LSaber36/smart-outlet/README.md

# smart-outlet
This repository is for a smart outlet project.
The smart-outlet will be able to read current and turn the outlet on and off.
Combining these basic inputs and outputs with features in the app, a user will have 
full control over the power they are using from the given outlet.
