LSaber36/smart-outlet/firmware/README.md

# firmware
This directory will hold all of the code that allows the physical device to work.

NOTE:
The firebase communication will not work without the firebaseInfo.h file being in the smartOutlet project folder.
This is being left out for security purposes.
