LSaber36/smart-outlet/eagle-files/SmartOutlet/Motherboard.brd

## EAGLE design eagle-files/SmartOutlet/Motherboard.brd (2022-07-14)

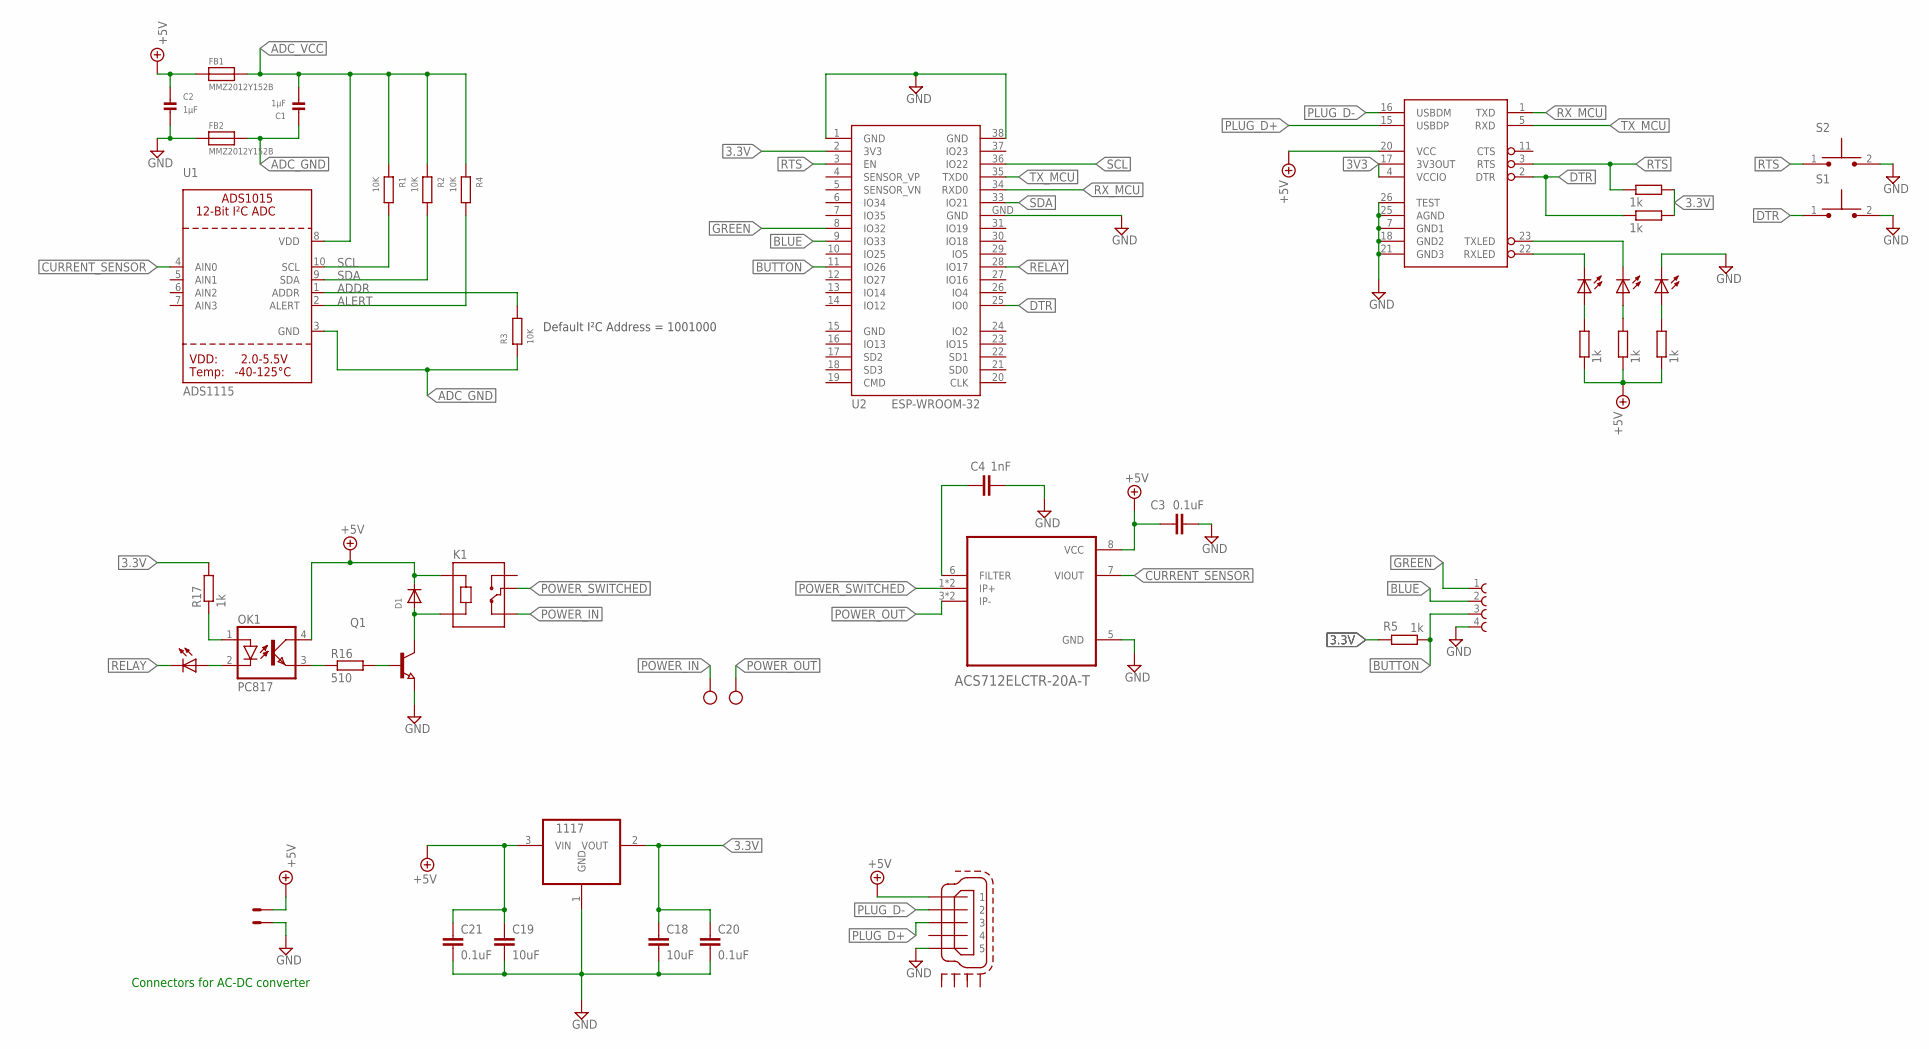
[picture p1: schematic Motherboard.sch]

Parts:
C1, C2: 1µF; 0805
C3, C20, C21: 0.1uF; 0603
C4: 1nF; 0603
C18, C19: 10uF; 1206
D1: DIODE_SOD-123FL; SOD-123FL
FB1, FB2: MMZ2012Y152B; 0805
IC1: 1117; SOT223
K1: SRD-05VDC-SL-C; RELAY_SRD-05VDC-SL-C
K2: 68610414122
OK1: PC817; DIL04
POWER_LED: LEDCHIP-LED0603; CHIP-LED0603
Q1: NPN-TRANSISTOR_SOT23; SOT23
R1, R2, R3, R4: 10K; R0603
R5, R7, R8, R9, R10, R11, R17: 1k; R0603
R16: 510; R0603
RELAY: LEDCHIP-LED0603; CHIP-LED0603
RX_LED: LEDCHIP-LED0603; CHIP-LED0603
S1, S2: TL1015AF160QG; SW_TL1015AF160QG
TX_LED: LEDCHIP-LED0603; CHIP-LED0603
U1: ADS1115; MSOP10
U2: ESP-WROOM-32
U3: FT232RL; SSOP28DB
U4: ACS712ELCTR-20A-T; SOIC127P600X175-8N
U$2: ZX62D-B-5P8
X1: W237-102
X2: 22-23-2021

Connections:
3.3V: C18.1, C20.1, IC1.2 (VOUT), R5.1, R8.2, R11.2, R17.2, U2.2 (3V3)
3V3: U3.4 (VCCIO), U3.17 (3V3OUT)
+5V: C2.1, C3.1, C19.1, C21.1, D1.C, FB1.1, IC1.3 (VIN), K1.A1, OK1.4 (COL), R7.1, R9.1, R10.1, U3.20 (VCC), U4.8 (VCC), U$2.P$1 (1), X2.1
ACS_FILTER: C4.1, U4.6 (FILTER)
ADC_GND: C1.1, FB2.2, R3.1, U1.3 (GND)
ADC_VCC: C1.2, FB1.2, R1.1, R2.1, R4.1, U1.8 (VDD)
ADDR: R3.2, U1.1 (ADDR)
ALERT: R4.2, U1.2 (ALERT)
BLUE: K2.2, U2.9 (IO33)
BUTTON: K2.3, R5.2, U2.11 (IO26)
CURRENT_SENSOR: U1.4 (AIN0), U4.7 (VIOUT)
DTR: R11.1, S1.1, U2.25 (IO0), U3.2 (DTR)
GND: C2.2, C3.2, C4.2, C18.2, C19.2, C20.2, C21.2, FB2.1, IC1.1 (GND), K2.4, POWER_LED.C, Q1.2 (E), S1.2, S2.2, U2.1 (GND), U2.15 (GND), U2.38 (GND), U2.GND, U3.7 (GND1), U3.18 (GND2), U3.21 (GND3), U3.25 (AGND), U3.26 (TEST), U4.5 (GND), U$2.P$5 (5), X2.2
GREEN: K2.1, U2.8 (IO32)
unnamed: OK1.2 (C), RELAY.A
unnamed: OK1.1 (A), R17.1
unnamed: R10.2, TX_LED.A
unnamed: OK1.3 (EMIT), R16.1
unnamed: Q1.1 (B), R16.2
unnamed: R9.2, RX_LED.A
PLUG_D+: U3.15 (USBDP), U$2.P$3 (3)
PLUG_D-: U3.16 (USBDM), U$2.P$2 (2)
POWER_IN: K1.NC, X1.1
POWER_LED: POWER_LED.A, R7.2
POWER_OUT: U4.3 (IP-), U4.4 (IP-), X1.2
POWER_SWITCHED: K1.COM, U4.1 (IP+), U4.2 (IP+)
RELAY: RELAY.C, U2.28 (IO17)
RELAY_GND: D1.A, K1.A2, Q1.3 (C)
RTS: R8.1, S2.1, U2.3 (EN), U3.3 (RTS)
RX_LED: RX_LED.C, U3.22 (RXLED)
RX_MCU: U2.34 (RXD0), U3.1 (TXD)
SCL: R1.2, U1.10 (SCL), U2.36 (IO22)
SDA: R2.2, U1.9 (SDA), U2.33 (IO21)
TX_LED: TX_LED.C, U3.23 (TXLED)
TX_MCU: U2.35 (TXD0), U3.5 (RXD)

Notes on the sheet:
Default I²C Address = 1001000
Connectors for AC-DC converter

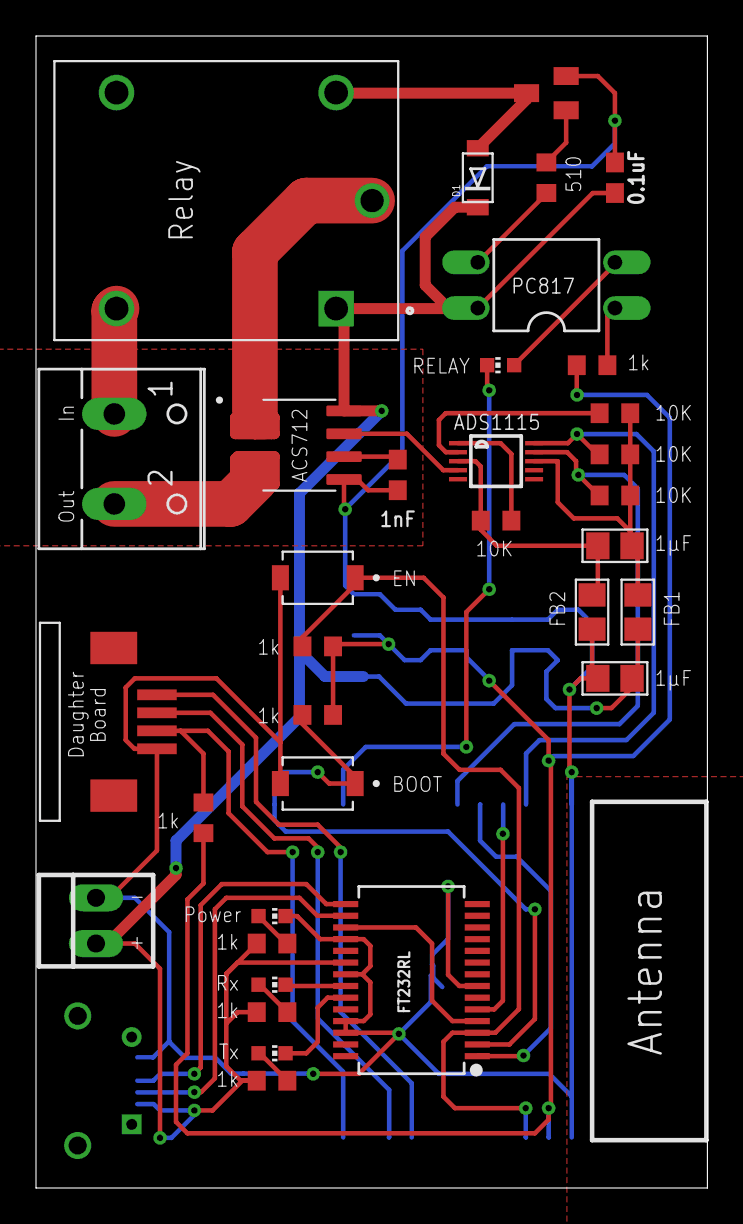
[picture p2: board Motherboard.brd from above]

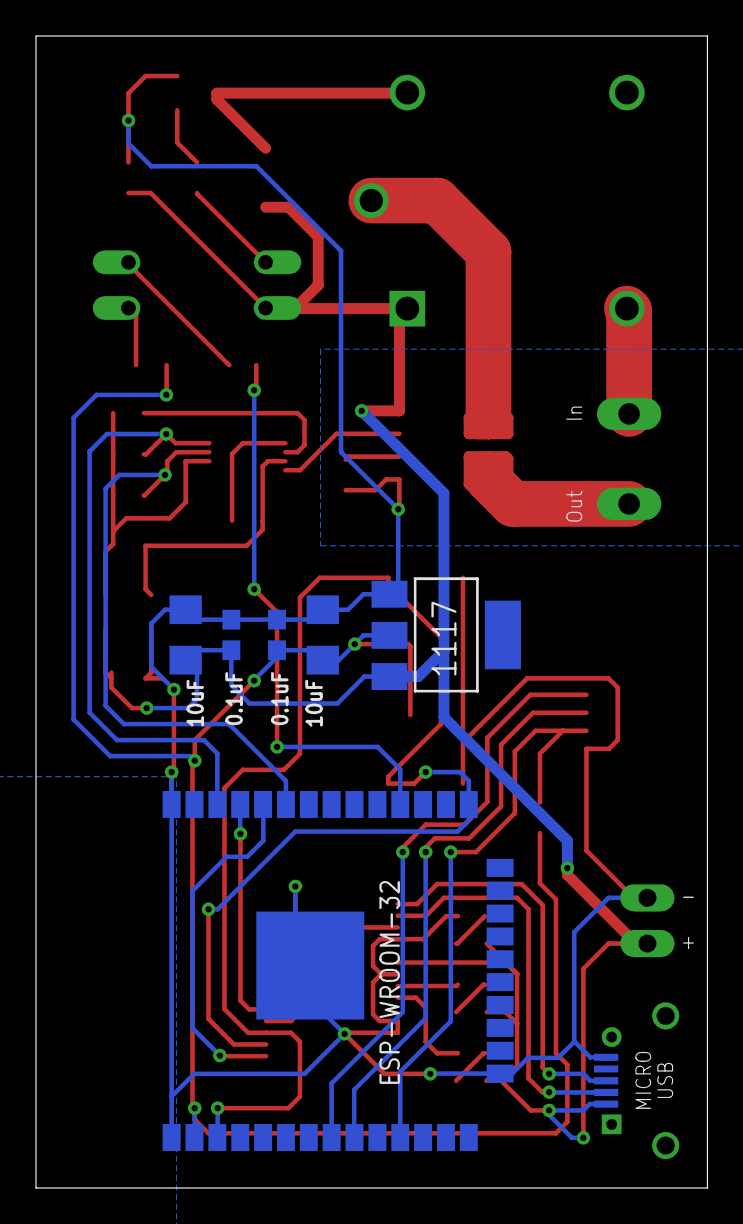
[picture p3: board Motherboard.brd from below]

Board: 2 copper layers, 37.3 x 64.0 mm, 41 parts (7 on the bottom side), 35 nets.
