LSaber36/smart-outlet/eagle-files/SmartOutlet/ButtonLedBoard.brd

## EAGLE design eagle-files/SmartOutlet/ButtonLedBoard.brd (2022-07-08)

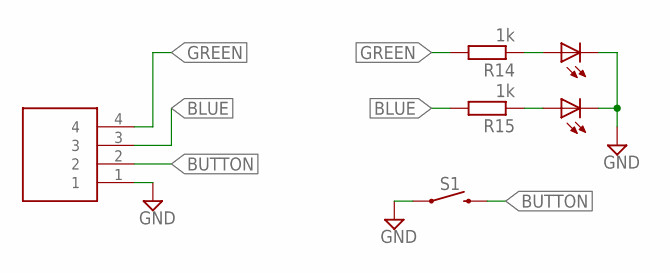
[picture p4: schematic ButtonLedBoard.sch]

Parts:
J1: 826629-4; TE_826629-4
LED1, LED2: LEDCHIP-LED0603; CHIP-LED0603
R14, R15: 1k; R0603
S1: MOMENTARY-SWITCH-SPST-SMD-6.0X3.5MM; TACTILE_SWITCH_SMD_6.0X3.5MM

Connections:
BLUE: J1.3, R15.2
BUTTON: J1.2, S1.2
GND: J1.1, LED1.C, LED2.C, S1.1
GREEN: J1.4, R14.2
unnamed: LED1.A, R14.1
unnamed: LED2.A, R15.1

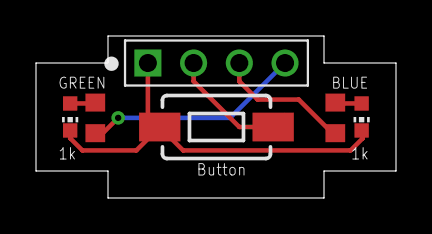
[picture p5: board ButtonLedBoard.brd from above]

Board: 2 copper layers, 20.0 x 9.0 mm, 6 parts (0 on the bottom side), 6 nets.
