LSaber36/smart-outlet/firmware/smartOutlet/smartOutlet.ino

#include <Adafruit_ADS1X15.h>
#include <WiFi.h>
#include <Firebase_ESP_Client.h>
#include <addons/TokenHelper.h>
#include <addons/RTDBHelper.h>
#include "firebaseInfo.h"
#include "time.h"

#include <BLEDevice.h>
#include <BLEServer.h>
#include <BLEUtils.h>
#include <BLE2902.h>

#include <Preferences.h>

#define GREEN_LED 32
#define BLUE_LED 33
#define BUTTON_PIN 26
#define RELAY_PIN 17
#define NUM_SAMPLES 50
#define UPDATE_INTERVAL 3000
#define ADC_READ_INTERVAL 5  // In minutes

#define SHORT_PRESS_TIME 1000
#define LONG_PRESS_TIME 3000
#define MULTI_BUTTON_PRESS_TIME 750
#define NUM_MULTI_PRESS 3
#define WIFI_TIMEOUT 6000

#define SERVICE_UUID            "6E400001-B5A3-F393-E0A9-E50E24DCCA9E"
#define CHARACTERISTIC_UUID_RX  "6E400002-B5A3-F393-E0A9-E50E24DCCA9E"
#define CHARACTERISTIC_UUID_TX  "6E400003-B5A3-F393-E0A9-E50E24DCCA9E"

enum RECEIVED_DATA_UPDATE
{
  NO_CHANGE = 0,
  RELAY_STATE = 1,
  POWER_THRESHOLD = 2,
  INITIAL_UPDATE = 3
};

// Define preferences object for flash access
Preferences savedInfo;
String currentSsid, currentPass, currentUuid;
volatile bool hasSavedInfo = false;

// Define ADC object
Adafruit_ADS1015 ads;

// Define Firebase Data objects
FirebaseData stream;
FirebaseData fbdo;

// Define Firebase auth and config objects
FirebaseAuth auth;
FirebaseConfig config;

unsigned long sendDataPrevMillis = 0;

// Realtime Data
volatile bool firstStreamUpdate = true, firebaseEstablished = false;
volatile int dataChanged = NO_CHANGE;
String deviceID = "";
String stateDatapath = "";

// ADC data
float ADCMultiplier = 2.0F;
float ADCResult;  //Voltage
float ADCValue;   //Current
float averageVoltage;
float maxv;
float power;
uint8_t sampleCounter;
unsigned long prevADCTime = 0;
bool firstADCCheck = true;

bool ADCInitialized = false;

// Button data
uint8_t currButtonState = 1;
uint8_t prevButtonState = 1;
unsigned long prevMillis = 0, releasedPressTime = 0, depressedPressTime = 0;
unsigned long prevButtonCountTime = 0, buttonCountTime = 0;
uint8_t buttonPressCount = 0;
volatile bool prevRelayState, relayState = false;
volatile int powerThreshold = 0;
volatile bool powerThresholdExceeded = false;

// Bluetooth data
BLEServer *pServer = NULL;
BLEService *pService;
BLECharacteristic *TxChar;
BLECharacteristic *RxChar;
bool deviceConnected = false;
bool oldDeviceConnected = false;
int8_t incomingData = 0, incomingDataCounter = 0;

// Define time variables
const char* ntpServer = "pool.ntp.org";
struct tm timeInfo;
int8_t prevMin = 0, timerMin = 0;
int8_t prevHour = 0;
float currentHourCumSum = 0;

// Mode for knowing wheter to boot in normal operation or in pairing mode
String mode;

void setup()
{
  Serial.begin(115200);
  Serial.printf("Starting Program...\n\n");
  
  // Init pinmodes
  pinMode(GREEN_LED, OUTPUT);
  pinMode(BLUE_LED, OUTPUT);
  pinMode(RELAY_PIN, OUTPUT);
  pinMode(BUTTON_PIN, INPUT_PULLUP);

  // Turn the relay off
  digitalWrite(RELAY_PIN, HIGH);

  // Check flash for existing values and print them
  getSavedInfo(&currentSsid, &currentPass, &currentUuid);
  Serial.printf("ssid: %s\n", currentSsid.c_str());
  Serial.printf("pass: %s\n", currentPass.c_str());
  Serial.printf("uuid: %s\n", currentUuid.c_str());
  Serial.println();

  getMode(&mode);
  Serial.printf("Mode: %s\n", mode);

  if (mode == "")
  {
    putMode("normal");
    mode = "normal";
  }
  // If there's ever the bug with the UUID being "7", don't let the outlet enter normal mode
  // The user MUST repair the outlet to get past this
  else if (currentUuid == "7")
  {
    mode = "pairing";
  }

  if (mode == "pairing")
  {
    Serial.println("Entered pairing mode");
    digitalWrite(GREEN_LED, LOW);
    digitalWrite(BLUE_LED, LOW);
    enterPairingMode();
  }
  else if (mode == "normal")
  {
    Serial.println("Entered normal mode");
    if (currentSsid == "" || currentPass == "" || currentUuid == "")
    {
      Serial.println("No data found, can't connect to network");
      hasSavedInfo = false;
    }
    else if (currentSsid != "" || currentPass != "" || currentUuid != "")
    {
      Serial.println("Found data, attempting network connection");
      hasSavedInfo = true;
      deviceID = currentUuid;
      stateDatapath = deviceID + "/state";
      setupWiFi(currentSsid, currentPass);
      delay(750);
      setupFirebase();
      setupADC();
    }
  }
}

void loop()
{
  getButtons();

  if (mode == "normal")
  {
    syncFirebase();
    getADCReading();

    if (dataChanged != NO_CHANGE)
    {
      if (firstStreamUpdate)
      {
        firstStreamUpdate = false;
        firebaseEstablished = true;
        Serial.println("\nFirebase Connection Established");

        getTime(&timeInfo);
        prevMin = timeInfo.tm_min;
        timerMin = timeInfo.tm_min;
        prevHour = timeInfo.tm_hour;
        Serial.printf("Current minutes: %d\n", timeInfo.tm_min);
        
        // Initialize the currentHourCumSum to what's in the database for the current hour in case of a power failure
        currentHourCumSum = getHistoricalData(timeInfo.tm_hour);
        Serial.printf("Set currentHourCumSum: %.1f\n", currentHourCumSum);

        // Indicate that the code is running
        blinkLED(GREEN_LED, 100, 150, 2);
        blinkLED(BLUE_LED, 100, 150, 2);
      }

      // Process new data received away from callback for efficiency
      if (dataChanged == RELAY_STATE)
      {
        Serial.printf("Received state update: %s\n", (relayState) ? "true" : "false");
      }
      else if (dataChanged == POWER_THRESHOLD)
      {
        Serial.printf("Received threshold update: %d\n", powerThreshold);
      }
      else if (dataChanged == INITIAL_UPDATE)
      {
        Serial.println("Initial update, initializing variables");
        Serial.printf("powerThreshold: %d\n", powerThreshold);
        Serial.printf("state: %s\n", (relayState) ? "true" : "false");
      }
      
      dataChanged = NO_CHANGE;
    }

    // Only call digitalWrite if the state has changed (reduces unnecessary calls)
    if (relayState != prevRelayState)
    {
      digitalWrite(RELAY_PIN, relayState);
      digitalWrite(GREEN_LED, relayState);
    }

    prevRelayState = relayState;
  }
  else if (mode == "pairing")
  {
    if (deviceConnected)
    {        
      delay(1000); // bluetooth stack will go into congestion, if too many packets are sent
    }

    if (!deviceConnected && oldDeviceConnected)
    {
      // Do stuff here after disconnected
      // give the bluetooth stack the chance to get things ready
      delay(500);
      
      oldDeviceConnected = deviceConnected;
    }
    if (deviceConnected && !oldDeviceConnected)
    {
      // Do stuff here after connection is established
      blinkLED(BLUE_LED, 100, 300, 2);
      oldDeviceConnected = deviceConnected;
    }
  }

  // This is necessary to avoid watchdog timer errors
  delay(10);
}
