LSaber36/smart-outlet/firmware/smartOutlet/currentSensorFunctions.ino

void setupADC()
{
  ads.setGain(GAIN_ONE);
  Serial.println("Attempting to initialize ADS");

  if (!ads.begin())
  {
    Serial.println("Failed to initialize ADS.");
  }
  else
  {
    Serial.println("Initialized ADS");
    ADCInitialized = true;
  
    sampleCounter = 0;
    averageVoltage = 0;

    while (sampleCounter < 50)
    {
      ADCResult = ads.readADC_SingleEnded(0) * ADCMultiplier / 1000;
      averageVoltage = averageVoltage + ADCResult;
      sampleCounter++;
      delay(4);
    }
    averageVoltage = averageVoltage / sampleCounter;
    maxv = averageVoltage;

  }
}

void getADCReading()
{
  // Without this if check, calling readADC_Differential_0_1() causes an infinite loop
  if (ADCInitialized)
  {
    if (firstADCCheck)
    {
      prevADCTime = millis();
      firstADCCheck = false;
    }

    if (millis() - prevADCTime < 3000)
    {
      //ADCResult = ads.readADC_Differential_0_1() * ADCMultiplier / 1000;
      ADCResult = ads.readADC_SingleEnded(0) * ADCMultiplier / 1000;

      // Get the min and max values for 1 second
      if (maxv < ADCResult)
        maxv = ADCResult;   

    }

    else
    {        
      ADCValue = (maxv - averageVoltage) * 10;
      
      //Ignore small voltage differences
      if((maxv - averageVoltage) < .02)
        ADCValue = 0;  

      Serial.printf("Voltage Reading: %.2f\n", ADCResult);
      Serial.printf("MaxV: %.2f\n", maxv);
      Serial.printf("Average Voltage: %.2f\n", averageVoltage);
      Serial.printf("IRMS Current?: %.2f\n", ADCValue);
      Serial.println();

      power = (ADCValue * 120) / 1000;
      maxv = averageVoltage;
      firstADCCheck = true;
    }
  }
} 
