LSaber36/smart-outlet/firmware/smartOutlet/functions.ino

void setupWiFi()
{
  WiFi.begin(WIFI_SSID, WIFI_PASSWORD);
  Serial.print("Connecting to Wi-Fi");

  while (WiFi.status() != WL_CONNECTED)
  {
    Serial.print(".");
    delay(300);
  }

  Serial.println();
  Serial.print("Connected with IP: ");
  Serial.println(WiFi.localIP());
  Serial.println();
}

void setupFirebase()
{
  Serial.println("Setting up firebase connection");
  Serial.printf("Firebase Client v%s\n\n", FIREBASE_CLIENT_VERSION);

  // Assign the api key (required)
  config.api_key = API_KEY;

  // Assign the user sign in credentials
  auth.user.email = USER_EMAIL;
  auth.user.password = USER_PASSWORD;

  // Assign the RTDB URL (required)
  config.database_url = DATABASE_URL;

  // Assign the callback function for the long running token generation task
  config.token_status_callback = tokenStatusCallback;

  Firebase.begin(&config, &auth);
  Firebase.reconnectWiFi(true);
  Firebase.setDoubleDigits(5);
}

void blinkLED(uint8_t led)
{
  digitalWrite(led, HIGH);
  delay(100);
  digitalWrite(led, LOW);
  delay(200);
  digitalWrite(led, HIGH);
  delay(100);
  digitalWrite(led, LOW);
}

void printSensorData()
{
  
}
