LSaber36/smart-outlet/(commit log)

2022-04-19 Added device page for each individual outlet
2022-05-17 Added scrollview for devices
2022-05-18 Added button navigation to device page and data passing
2022-05-19 Added arduino code for realtime database access and changed styles
2022-05-21 Added check in case outlet id being parsed does not exist
2022-05-21 Added ability to add devices to Firestore and read list from Firestore
2022-05-22 Updated naming from device to outlet
2022-05-22 Updated ESP32 code to work with Firestore, not Realtime database
2022-05-31 Updated flow of app to allow for automatic sign-in and proper login/logout
2022-06-02 Updated auth flow to include signup and email verification
2022-06-02 Removed back buttons made unnecessary by nav bar
2022-06-07 Added view to align info on device page
2022-06-09 Added button to toggle outlet state
2022-06-09 Moved settings navigation button to nav bar as an icon
2022-06-09 Added power variable to outlet objects
2022-06-09 Sorted outlet device list
2022-06-13 Updated arduino code to subscribe to changes in outlet state via realtime database
2022-06-15 Relay Function Working Current Sensor Function with ADS 1115 in progress
2022-06-16 Updated color so it shows up on android device
2022-06-17 Updated arduino code to work with codebase
2022-06-17 Added data averaging to ADC data calculation
2022-06-21 Added button timer code
2022-06-21 Added if-statement to only change relayState if needed
2022-06-21 Updated styles for physical device
2022-06-21 Updated print statements for readability
2022-06-23 Added updated eagle files
    [Motherboard.brd, Motherboard.sch]
2022-06-25 Updated error message case and variable name
2022-06-25 Updated ESP32 deviceID
2022-06-25 Added disabled button style
2022-06-25 Updated addOutlet flow
2022-06-25 Updated eagle files
    [Motherboard.brd, Motherboard.sch]
2022-06-26 Added graphs with static data to device page
2022-06-27 Added setThreshold functionality to device modal, has small bugs
2022-06-28 Moved buttons to inside of scrollview and increased size
2022-06-28 Updated button styles
2022-06-28 Updated device info view
2022-06-29 Updated buttons to have elevation
2022-07-01 Fixed bug where new user cannot add devices
2022-07-02 Made logout button higher
2022-07-02 Updated add device styling
2022-07-02 Updated add device message
2022-07-05 Fixed bug with firebase not working
    [currentSensorFunctions.ino, firebaseFunctions.ino, mainFunctions.ino, smartOutlet.ino]
2022-07-07 Added daughter board and edited motherboard
    [ButtonLedBoard.brd, ButtonLedBoard.sch, Motherboard.brd, Motherboard.sch]
2022-07-08 Updated PCB design
    [ButtonLedBoard.brd, ButtonLedBoard.sch, Motherboard.brd, Motherboard.sch]
2022-07-10 Updated console logging for user device list for readability
2022-07-10 Updated code to print user auth data once for readability
2022-07-10 Updated code to print user device list dynamically based on size
2022-07-11 Added functionality to find current network name and verify a password for it
2022-07-11 Changed timer blinking led to green instead of blue
2022-07-11 Updated firmware to blink LEDs at correct time and print better console messages
    [bluetoothFunctions.ino, smartOutlet.ino]
2022-07-12 Updated log printing for clarity
2022-07-12 Added framework for evalulating network status based on incoming data
2022-07-14 Added code to interact with flash memory storage and print information with button presses for testing
2022-07-14 Updated code to reboot device after connection is extablisted
2022-07-14 Removed test button code for setting values in flash memory
2022-07-14 Added support for short multi button press
    [mainFunctions.ino, smartOutlet.ino]
2022-07-15 Updated Current Sensor function -Changed to ADS1015 -Added new variables to Smart Outlet for ads reading:maxv,minv, counter -Changed current sensor fuinction from measuring average to finding min and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
2022-07-15 Fixed things to account for new Current sensor code
    [currentSensorFunctions.ino]
2022-07-16 Added support for pressing button to change state. Required separating firebase and bluetooth with different boot modes
2022-07-16 Removed unused variable causing runtime error
    [currentSensorFunctions.ino]
2022-07-16 Enclosed adc initialization in if statement to prevent infinite loop
    [currentSensorFunctions.ino]
2022-07-16 Added delay to make firebase sync correctly on reboot
    [smartOutlet.ino]
2022-07-18 Fixed button lag problem and optimized ADC performance
    [currentSensorFunctions.ino, smartOutlet.ino]
2022-07-19 Moved powerThreshold to realtime database for app
2022-07-20 Updated to set moethod to ensure correct update type on esp32
2022-07-20 Edited firebase listener to listen and distinguish updates from powerThreshold and state
2022-07-20 Removed x-axis lable rotation
2022-07-20 Updated code so relay pin state is set properly on initialization
2022-07-21 Added historicalData reset function
    [firebaseFunctions.ino]
2022-07-21 Added power pointer and calculation
2022-07-21 power pointer added and caluctation
2022-07-21 Updated functions with filler code and updated print statements
2022-07-21 Added function to get time at current index in case of power outage
2022-07-21 Updated print statement for clarity
2022-07-21 Added ADC and historicalData function calls to timer code
2022-07-21 Commented out current print functions
2022-07-22 Updated code to properly turn outlet off if outlet power threshold has been exceeded
2022-07-22 Updated current sensor stuff moved things
2022-07-22 Added fix for UUID = 7 bug
    [smartOutlet.ino]
