LSaber36/smart-outlet/(notices)

Notices in the files:
parts and their libraries:
esp32: Creative Commons Attribution-ShareAlike 4.0 International
SparkFun-IC-Comms: Licensing: Creative Commons ShareAlike 4.0 International - https://creativecommons.org/licenses/by-sa/4.0
4_pin_smd_connector: Copyright: Würth Elektronik
